matthewdias/minim/README.md

# minim
A symmetrical 50% keyboard

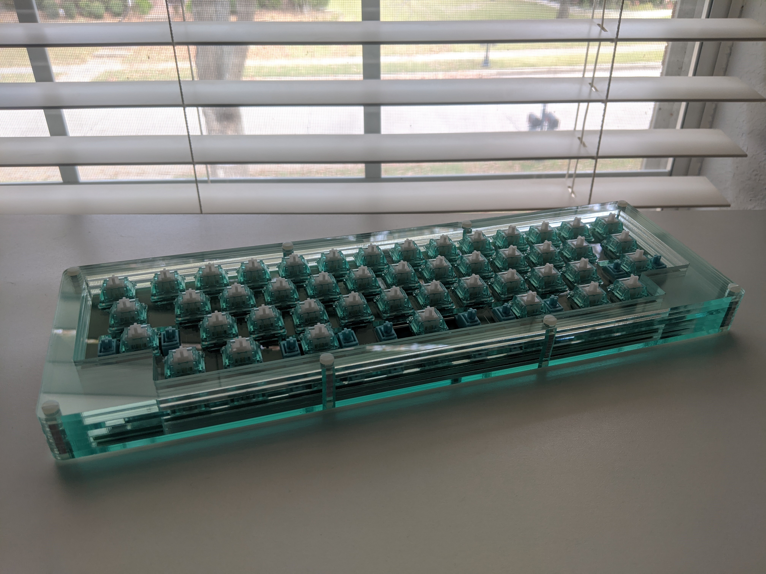
[picture p1: front.jpg]


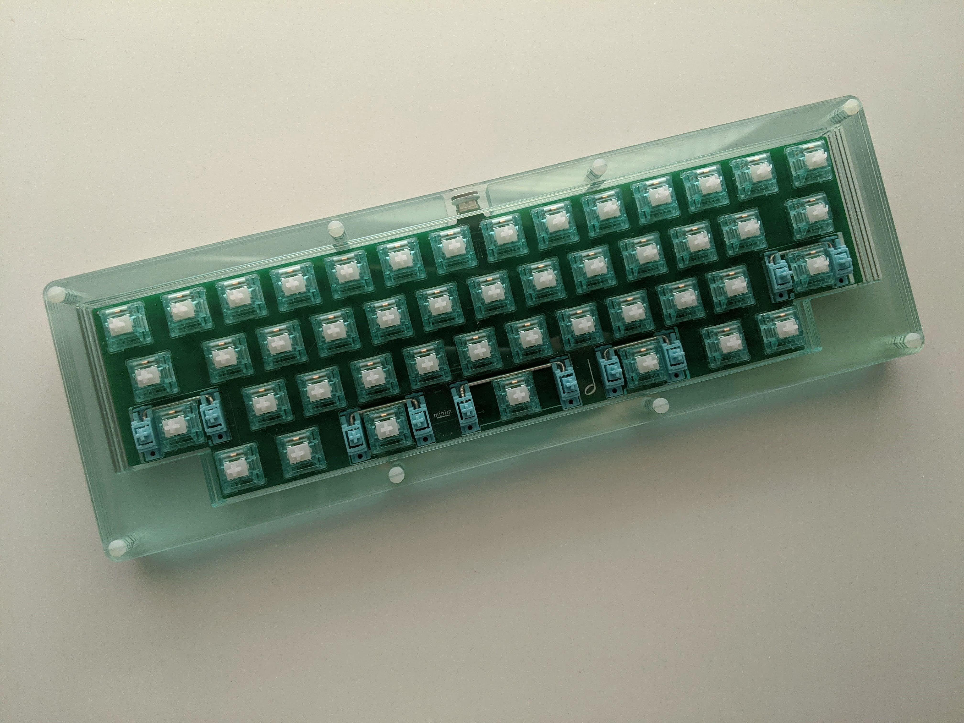
[picture p2: top.jpg]


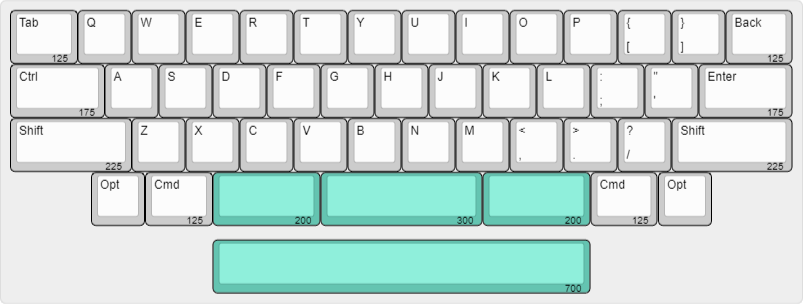
[picture p3: layout.png]
