matthewdias/minim/Case/Layer 7 - Bottom.dxf

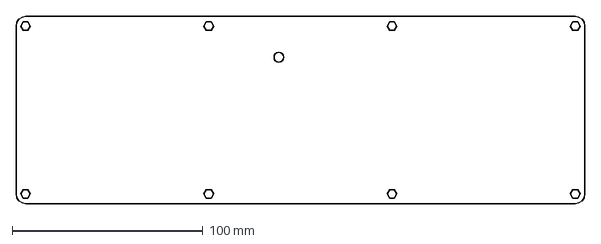
[picture p5: CAD file, 2020-11-15]
Case/Layer 7 - Bottom.dxf
298.4 x 98.2 mm
