matthewdias/minim/Case/sheet.dxf

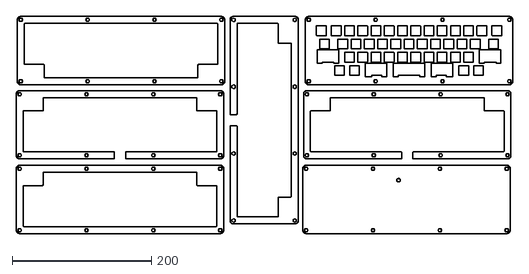
[picture p6: CAD file, 2020-11-15]
Case/sheet.dxf
714.1 x 312.3
