matthewdias/minim/Case/Layer 1,2 - Tops.dxf

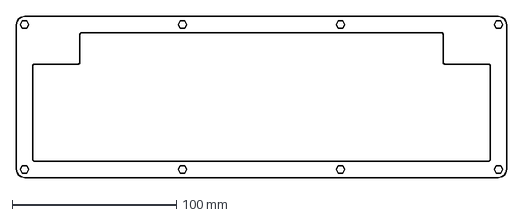
[picture p7: CAD file, 2020-11-15]
Case/Layer 1,2 - Tops.dxf
298.4 x 98.2 mm
