matthewdias/minim/Case/Layer 4,5,6 - Mids.dxf

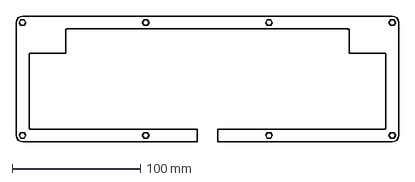
[picture p8: CAD file, 2020-11-15]
Case/Layer 4,5,6 - Mids.dxf
298.4 x 98.2 mm
