matthewdias/minim/Case/Layer 3 - Plate.dxf

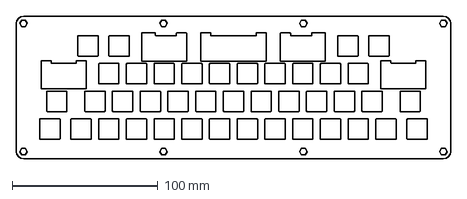
[picture p9: CAD file, 2020-11-15]
Case/Layer 3 - Plate.dxf
298.4 x 98.2 mm
