matthewdias/minim/(list of files, cad)

Other CAD files:
Case/minim.stl
