matthewdias/minim/PCB/minim.kicad_pcb

## KiCad design PCB/minim.kicad_pcb (2020-11-15)

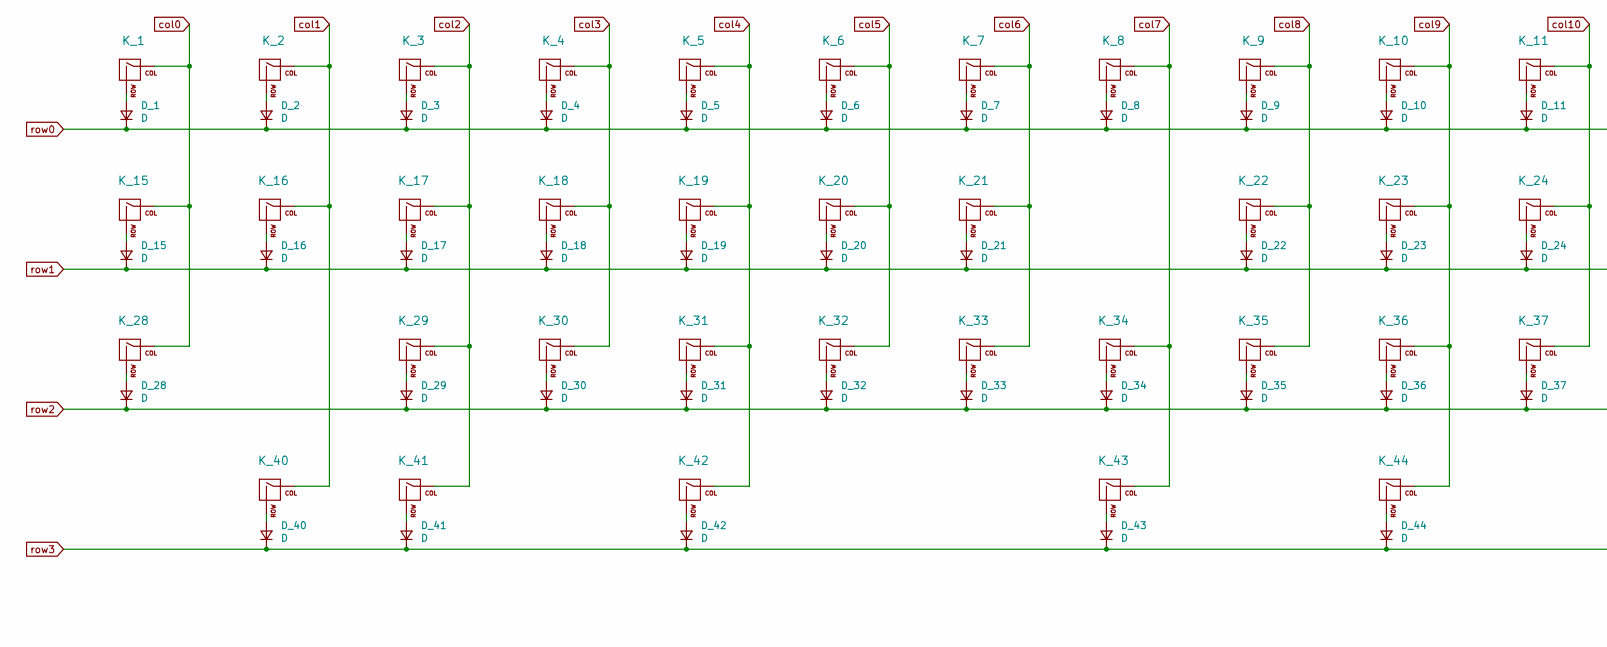
[picture p10: schematic minim.sch, part in row 1, column 1]

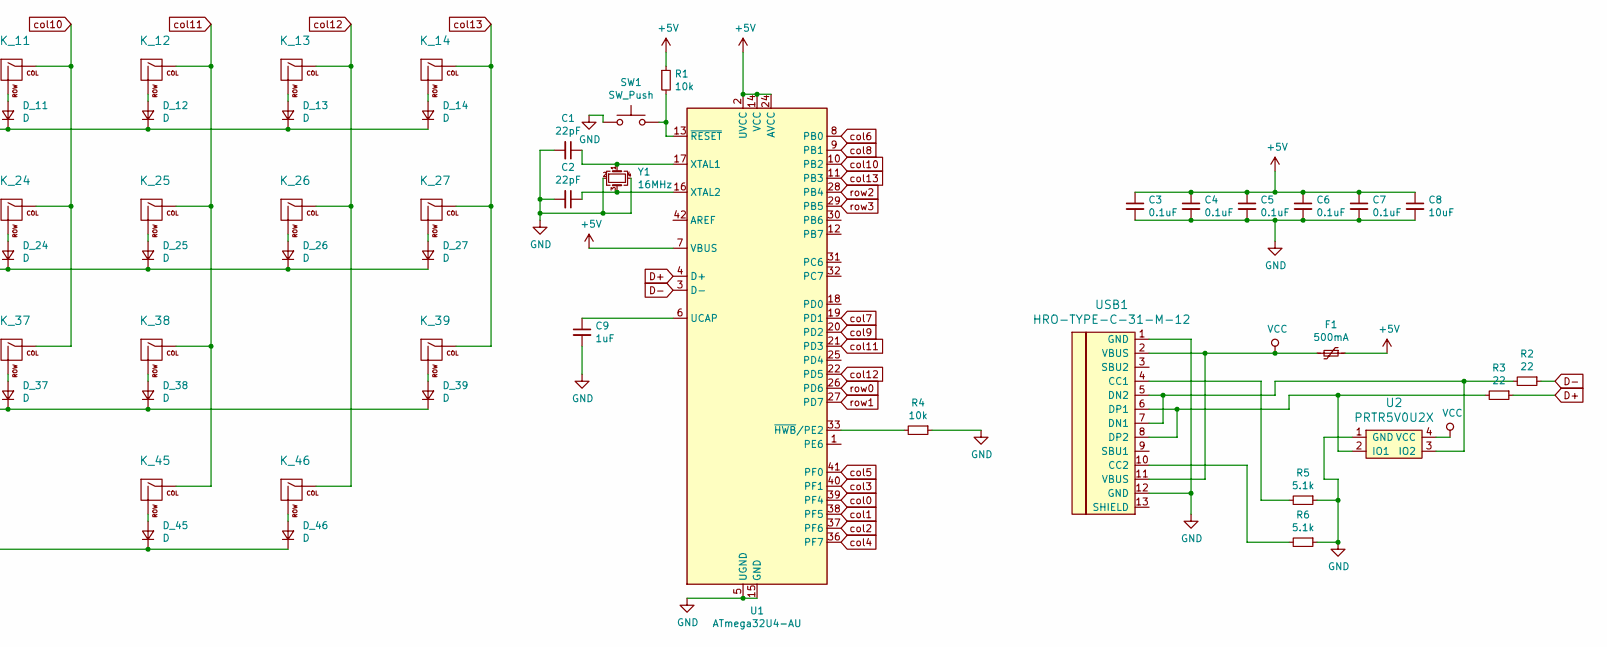
[picture p11: schematic minim.sch, part in row 1, column 2]

Parts:
C1, C2: 22pF; C_0805_2012Metric
C3, C4, C5, C6, C7: 0.1uF; C_0805_2012Metric
C8: 10uF; C_0805_2012Metric
C9: 1uF; C_0805_2012Metric
D_1, D_2, D_3, D_4, D_5, D_6, D_7, D_8, D_9, D_10, D_11, D_12, D_13, D_14, D_15, D_16, D_17, D_18, D_19, D_20, D_21, D_22, D_23, D_24, D_25, D_26, D_27, D_28, D_29, D_30, D_31, D_32, D_33, D_34, D_35, D_36, D_37, D_38, D_39, D_40, D_41, D_42, D_43, D_44, D_45, D_46: D; D_SOD-123
F1: 500mA; Fuse_1206_3216Metric
K_1, K_14, K_41, K_45: KEYSW; MXOnly-1.25U-NoLED
K_2, K_3, K_4, K_5, K_6, K_7, K_8, K_9, K_10, K_11, K_12, K_13, K_16, K_17, K_18, K_19, K_20, K_21, K_22, K_23, K_24, K_25, K_26, K_29, K_30, K_31, K_32, K_33, K_34, K_35, K_36, K_37, K_38, K_40, K_46: KEYSW; MXOnly-1U-NoLED
K_15, K_27: KEYSW; MXOnly-1.75U-NoLED
K_28, K_39: KEYSW; MXOnly-2.25U-ReversedStabilizers-NoLED
K_42, K_44: KEYSW; MXOnly-2U-ReversedStabilizers-NoLED
K_43: KEYSW; MXOnly-7U-3U-ReversedStabilizers-NoLED - Copy
R1, R4: 10k; R_0805_2012Metric
R2, R3: 22; R_0805_2012Metric
R5, R6: 5.1k; R_0805_2012Metric
SW1: SW_Push; SKQG-1155865
U1: ATmega32U4-AU; TQFP-44_10x10mm_P0.8mm
U2: PRTR5V0U2X; SOT143B
USB1: HRO-TYPE-C-31-M-12; HRO-TYPE-C-31-M-12-Assembly
Y1: 16MHz; Crystal_SMD_3225-4Pin_3.2x2.5mm

Connections:
+5V: C3.1, C4.1, C5.1, C6.1, C7.1, C8.1, F1.1, R1.1, U1.2 (UVCC), U1.7 (VBUS), U1.14 (VCC), U1.24 (AVCC), U1.34 (VCC), U1.44 (AVCC)
D+: R3.1, U1.4 (D+)
D-: R2.1, U1.3 (D-)
GND: C1.2, C2.2, C3.2, C4.2, C5.2, C6.2, C7.2, C8.2, C9.2, R4.1, R5.1, R6.1, SW1.1, U1.5 (UGND), U1.15 (GND), U1.23 (GND), U1.35 (GND), U1.43 (GND), U2.1 (GND), USB1.1 (GND), USB1.12 (GND), Y1.2, Y1.4
unnamed: C1.1, U1.17 (XTAL1), Y1.1
unnamed: C2.1, U1.16 (XTAL2), Y1.3
unnamed: C9.1, U1.6 (UCAP)
unnamed: D_1.2 (A), K_1.2 (ROW)
unnamed: D_2.2 (A), K_2.2 (ROW)
unnamed: D_3.2 (A), K_3.2 (ROW)
unnamed: D_4.2 (A), K_4.2 (ROW)
unnamed: D_5.2 (A), K_5.2 (ROW)
unnamed: D_6.2 (A), K_6.2 (ROW)
unnamed: D_7.2 (A), K_7.2 (ROW)
unnamed: D_8.2 (A), K_8.2 (ROW)
unnamed: D_9.2 (A), K_9.2 (ROW)
unnamed: D_10.2 (A), K_10.2 (ROW)
unnamed: D_11.2 (A), K_11.2 (ROW)
unnamed: D_12.2 (A), K_12.2 (ROW)
unnamed: D_13.2 (A), K_13.2 (ROW)
unnamed: D_14.2 (A), K_14.2 (ROW)
unnamed: D_15.2 (A), K_15.2 (ROW)
unnamed: D_16.2 (A), K_16.2 (ROW)
unnamed: D_17.2 (A), K_17.2 (ROW)
unnamed: D_18.2 (A), K_18.2 (ROW)
unnamed: D_19.2 (A), K_19.2 (ROW)
unnamed: D_20.2 (A), K_20.2 (ROW)
unnamed: D_21.2 (A), K_21.2 (ROW)
unnamed: D_22.2 (A), K_22.2 (ROW)
unnamed: D_23.2 (A), K_23.2 (ROW)
unnamed: D_24.2 (A), K_24.2 (ROW)
unnamed: D_25.2 (A), K_25.2 (ROW)
unnamed: D_26.2 (A), K_26.2 (ROW)
unnamed: D_27.2 (A), K_27.2 (ROW)
unnamed: D_28.2 (A), K_28.2 (ROW)
unnamed: D_29.2 (A), K_29.2 (ROW)
unnamed: D_30.2 (A), K_30.2 (ROW)
unnamed: D_31.2 (A), K_31.2 (ROW)
unnamed: D_32.2 (A), K_32.2 (ROW)
unnamed: D_33.2 (A), K_33.2 (ROW)
unnamed: D_34.2 (A), K_34.2 (ROW)
unnamed: D_35.2 (A), K_35.2 (ROW)
unnamed: D_36.2 (A), K_36.2 (ROW)
unnamed: D_37.2 (A), K_37.2 (ROW)
unnamed: D_38.2 (A), K_38.2 (ROW)
unnamed: D_39.2 (A), K_39.2 (ROW)
unnamed: D_40.2 (A), K_40.2 (ROW)
unnamed: D_41.2 (A), K_41.2 (ROW)
unnamed: D_42.2 (A), K_42.2 (ROW)
unnamed: D_43.2 (A), K_43.2 (ROW)
unnamed: D_44.2 (A), K_44.2 (ROW)
unnamed: D_45.2 (A), K_45.2 (ROW)
unnamed: D_46.2 (A), K_46.2 (ROW)
unnamed: R1.2, SW1.2, U1.13 (~RESET)
unnamed: R2.2, U2.3 (IO2), USB1.5 (DN2), USB1.7 (DN1)
unnamed: R3.2, U2.2 (IO1), USB1.6 (DP1), USB1.8 (DP2)
unnamed: R4.2, U1.33 (~HWB~/PE2)
unnamed: R5.2, USB1.4 (CC1)
unnamed: R6.2, USB1.10 (CC2)
VCC: F1.2, U2.4 (VCC), USB1.2 (VBUS), USB1.11 (VBUS)
col0: K_1.1 (COL), K_15.1 (COL), K_28.1 (COL), U1.39 (PF4)
col1: K_2.1 (COL), K_16.1 (COL), K_40.1 (COL), U1.38 (PF5)
col2: K_3.1 (COL), K_17.1 (COL), K_29.1 (COL), K_41.1 (COL), U1.37 (PF6)
col3: K_4.1 (COL), K_18.1 (COL), K_30.1 (COL), U1.40 (PF1)
col4: K_5.1 (COL), K_19.1 (COL), K_31.1 (COL), K_42.1 (COL), U1.36 (PF7)
col5: K_6.1 (COL), K_20.1 (COL), K_32.1 (COL), U1.41 (PF0)
col6: K_7.1 (COL), K_21.1 (COL), K_33.1 (COL), U1.8 (PB0)
col7: K_8.1 (COL), K_34.1 (COL), K_43.1 (COL), U1.19 (PD1)
col8: K_9.1 (COL), K_22.1 (COL), K_35.1 (COL), U1.9 (PB1)
col9: K_10.1 (COL), K_23.1 (COL), K_36.1 (COL), K_44.1 (COL), U1.20 (PD2)
col10: K_11.1 (COL), K_24.1 (COL), K_37.1 (COL), U1.10 (PB2)
col11: K_12.1 (COL), K_25.1 (COL), K_38.1 (COL), K_45.1 (COL), U1.21 (PD3)
col12: K_13.1 (COL), K_26.1 (COL), K_46.1 (COL), U1.22 (PD5)
col13: K_14.1 (COL), K_27.1 (COL), K_39.1 (COL), U1.11 (PB3)
row0: D_1.1 (K), D_2.1 (K), D_3.1 (K), D_4.1 (K), D_5.1 (K), D_6.1 (K), D_7.1 (K), D_8.1 (K), D_9.1 (K), D_10.1 (K), D_11.1 (K), D_12.1 (K), D_13.1 (K), D_14.1 (K), U1.26 (PD6)
row1: D_15.1 (K), D_16.1 (K), D_17.1 (K), D_18.1 (K), D_19.1 (K), D_20.1 (K), D_21.1 (K), D_22.1 (K), D_23.1 (K), D_24.1 (K), D_25.1 (K), D_26.1 (K), D_27.1 (K), U1.27 (PD7)
row2: D_28.1 (K), D_29.1 (K), D_30.1 (K), D_31.1 (K), D_32.1 (K), D_33.1 (K), D_34.1 (K), D_35.1 (K), D_36.1 (K), D_37.1 (K), D_38.1 (K), D_39.1 (K), U1.28 (PB4)
row3: D_40.1 (K), D_41.1 (K), D_42.1 (K), D_43.1 (K), D_44.1 (K), D_45.1 (K), D_46.1 (K), U1.29 (PB5)

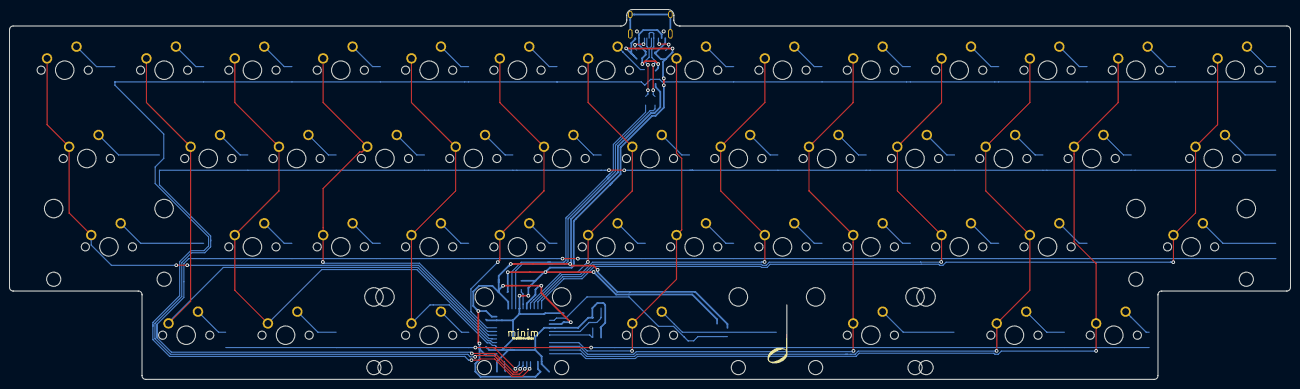
[picture p12: board minim.kicad_pcb from above]

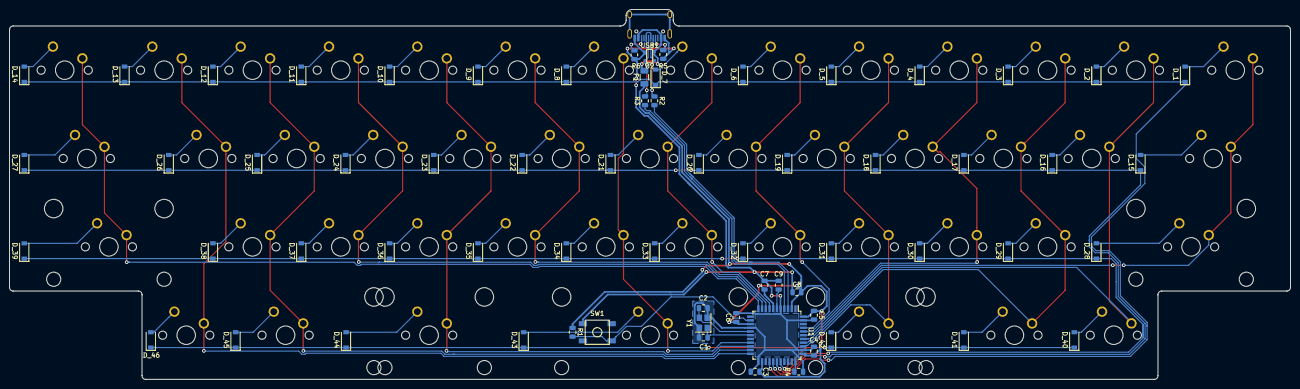
[picture p13: board minim.kicad_pcb from below]

Board: 2 copper layers, 276.2 x 79.8 mm, 114 parts (67 on the bottom side), 78 nets.

Other parts of the board:
LOGO1: LOGO; icon
