matthewdias/minim/(commit log)

2020-11-15 Add PCB files
    [bom.csv, footprint-positions.csv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]
2020-11-15 Add PCB Readme
2020-11-15 Add case files
    [Layer 1,2 - Tops.dxf, Layer 3 - Plate.dxf, Layer 4,5,6 - Mids.dxf, Layer 7 - Bottom.dxf, minim.stl, sheet.dxf]
